CokeZreo/DC_MOTORS/Docs/SCH_MOTOR.pdf

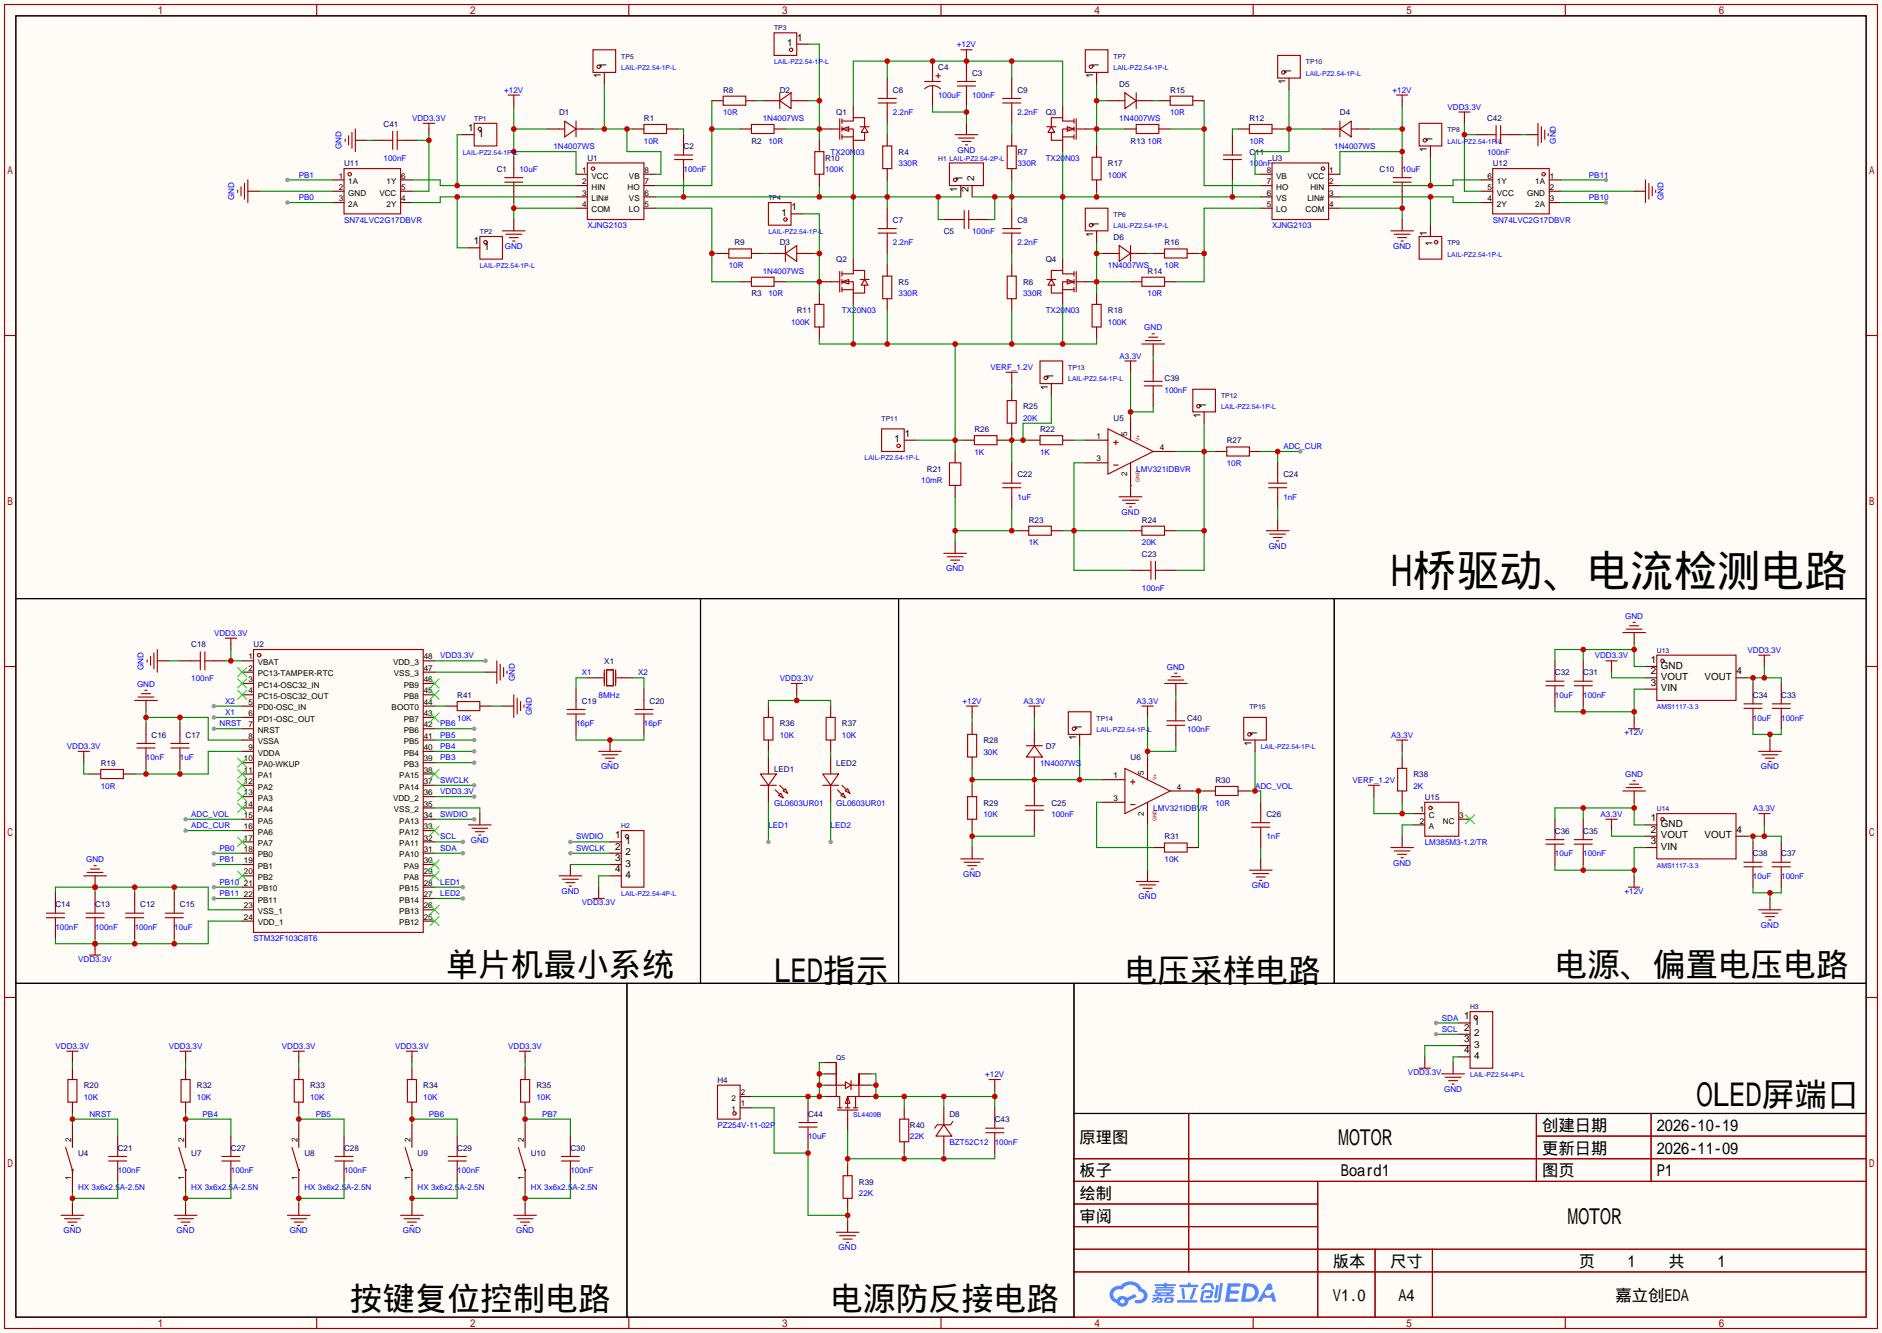
[picture p2: page 1]

原理图 | MOTOR | 创建日期 | 2026-10-19

更新日期 | 2026-11-09

板子 | Board1 | 图页 | P1
绘制 | | MOTOR
审阅

V1.0 | A4 | 嘉立创EDA
