CokeZreo/DC_MOTORS/DC_MOTORS/DC_MOTORS.ioc

Mcu.UserName=STM32F103C8Tx
PA10.Signal=GPIO_Output
PA11.Signal=GPIO_Output
PA13.Signal=SYS_JTMS-SWDIO
PA14.Signal=SYS_JTCK-SWCLK
PA5.Signal=ADCx_IN5
PA6.Signal=ADCx_IN6
PB0.Signal=GPIO_Output
PB1.Signal=S_TIM3_CH4
PB10.Signal=GPIO_Output
PB11.Signal=S_TIM2_CH4
PB14.Signal=GPIO_Output
PB15.Signal=GPIO_Output
PB3.Signal=GPIO_Input
PB4.Signal=GPIO_Input
PB5.Signal=GPIO_Input
PB6.Signal=GPIO_Input
PD0-OSC_IN.Signal=RCC_OSC_IN
PD1-OSC_OUT.Signal=RCC_OSC_OUT
