CokeZreo/DC_MOTORS/(commit log)

2026-11-09 添加 README 和 LICENSE
2026-11-09 README 和 LICENSE 移到仓库根目录
2026-11-09 添加原理图和 PCB 工程链接
2026-11-09 修改SCH_MOTOR
2026-11-09 更新SCH_MOTOR.pdf
2026-11-09 更新SCH_MOTOR
2026-11-09 更新SCH_MOTOR_PDF为PNG
2026-11-09 添加SCH_MOTOR.pdf
2026-11-09 更新SCH_MOTOR.png
2026-11-09 移除编译产物和本地配置，添加 .gitignore
2026-11-09 更新README
